juanignacio-martin/TRABAJO-FIN-DE-GRADO-Mediciones-Asfalto/README.md

# TRABAJO-FIN-DE-GRADO-Mediciones-Asfalto
Diseño e implementación del software de control y monitorización de un sistema de instrumentación avanzado para medidas de resistencia en asfalto.

Repositorio útil para investigadores de caminos para entendimiento del código usado en la versión final de la segunda PCB.

Abierto Público durante semana 28 Sept - 4 Oct, para presentación de TFG. 

Last update SEPT 26.
