juanignacio-martin/TRABAJO-FIN-DE-GRADO-Mediciones-Asfalto/DISEÑO/PCB-cara_inferior.pdf

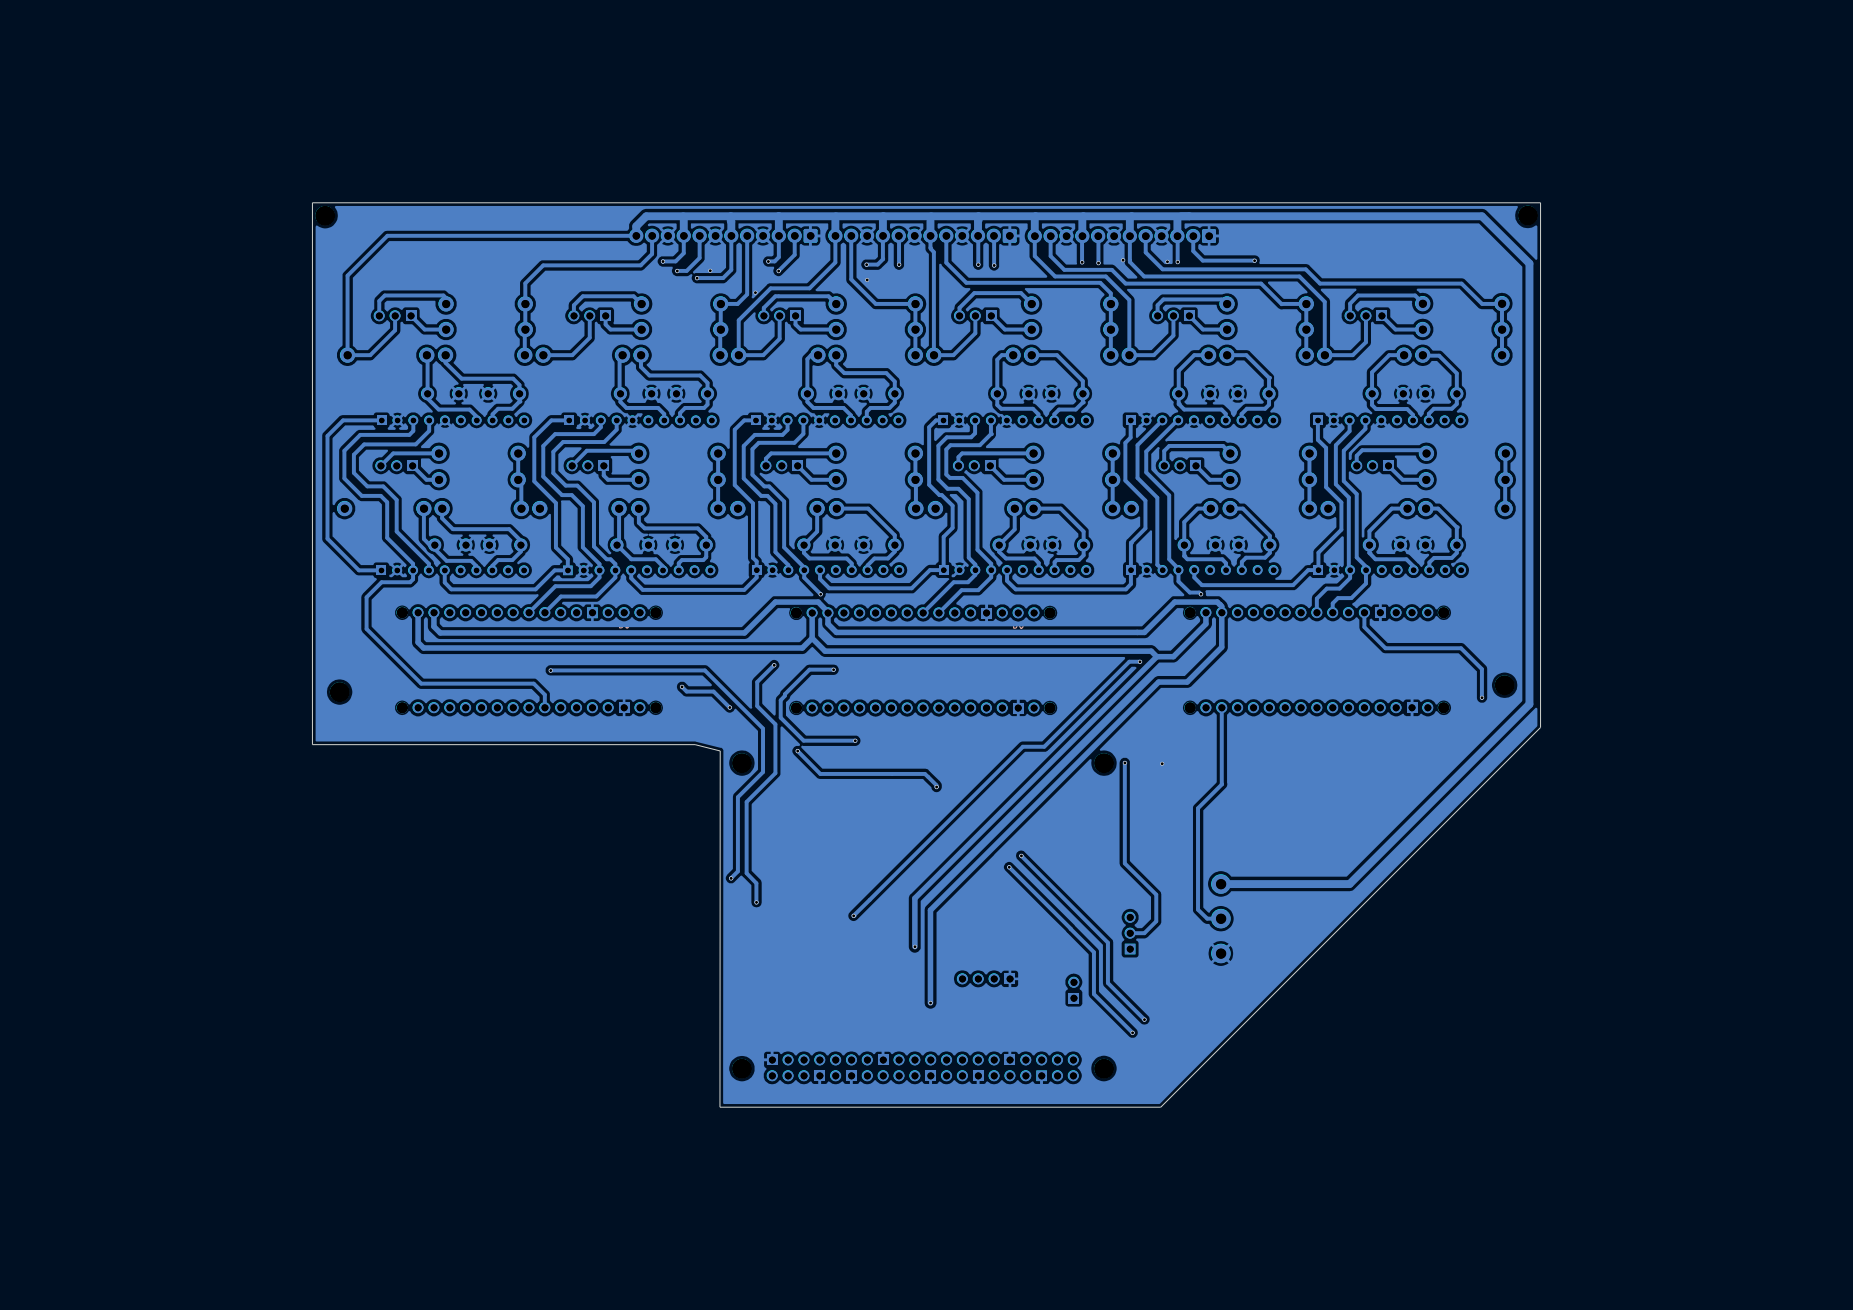
[picture p2: page 1]
