juanignacio-martin/TRABAJO-FIN-DE-GRADO-Mediciones-Asfalto/DISEÑO/PCB-cara_superior.pdf

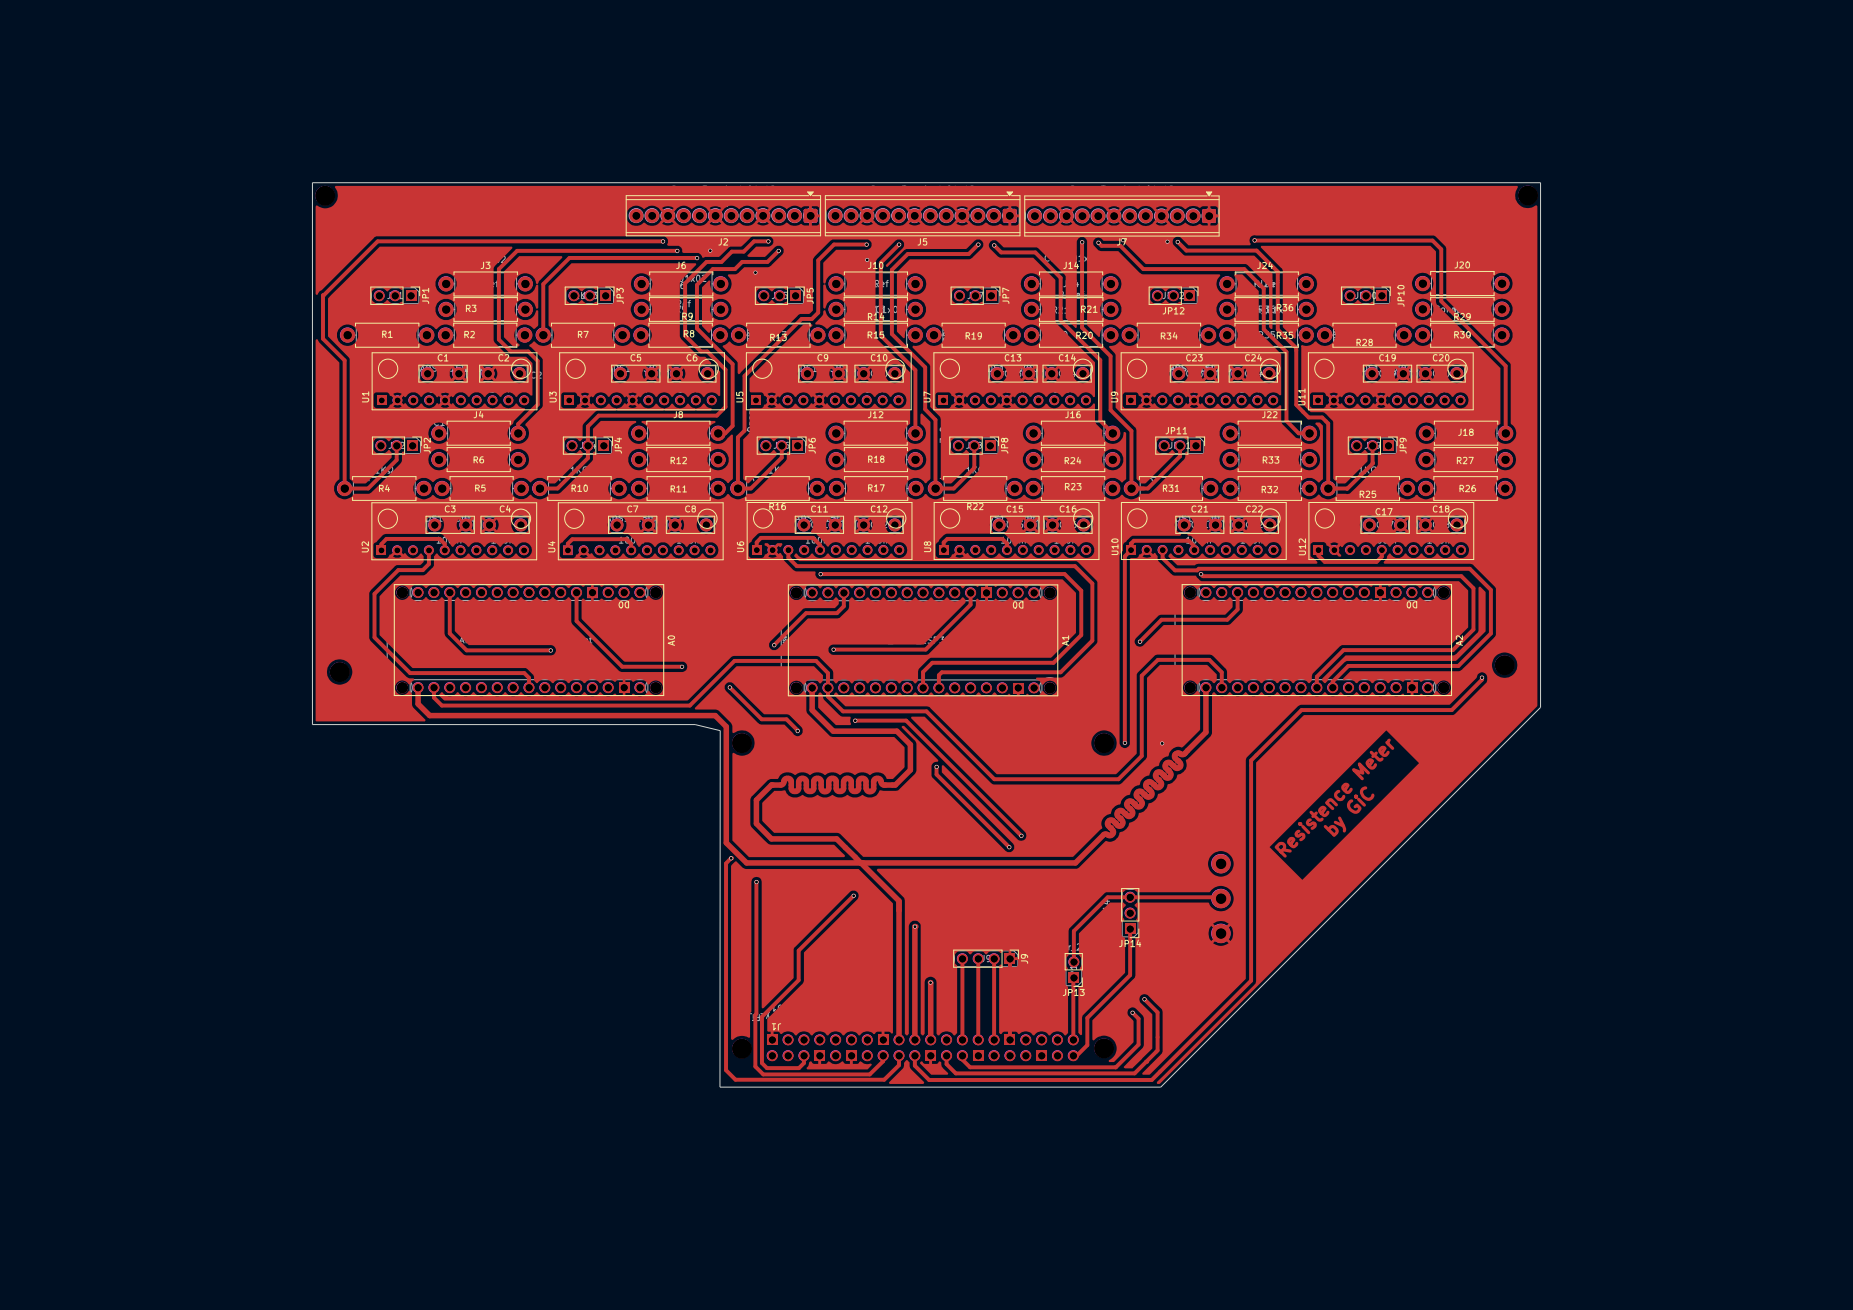
[picture p3: page 1]
