juanignacio-martin/TRABAJO-FIN-DE-GRADO-Mediciones-Asfalto/DISEÑO/SCHEMATIC-PCB2.pdf

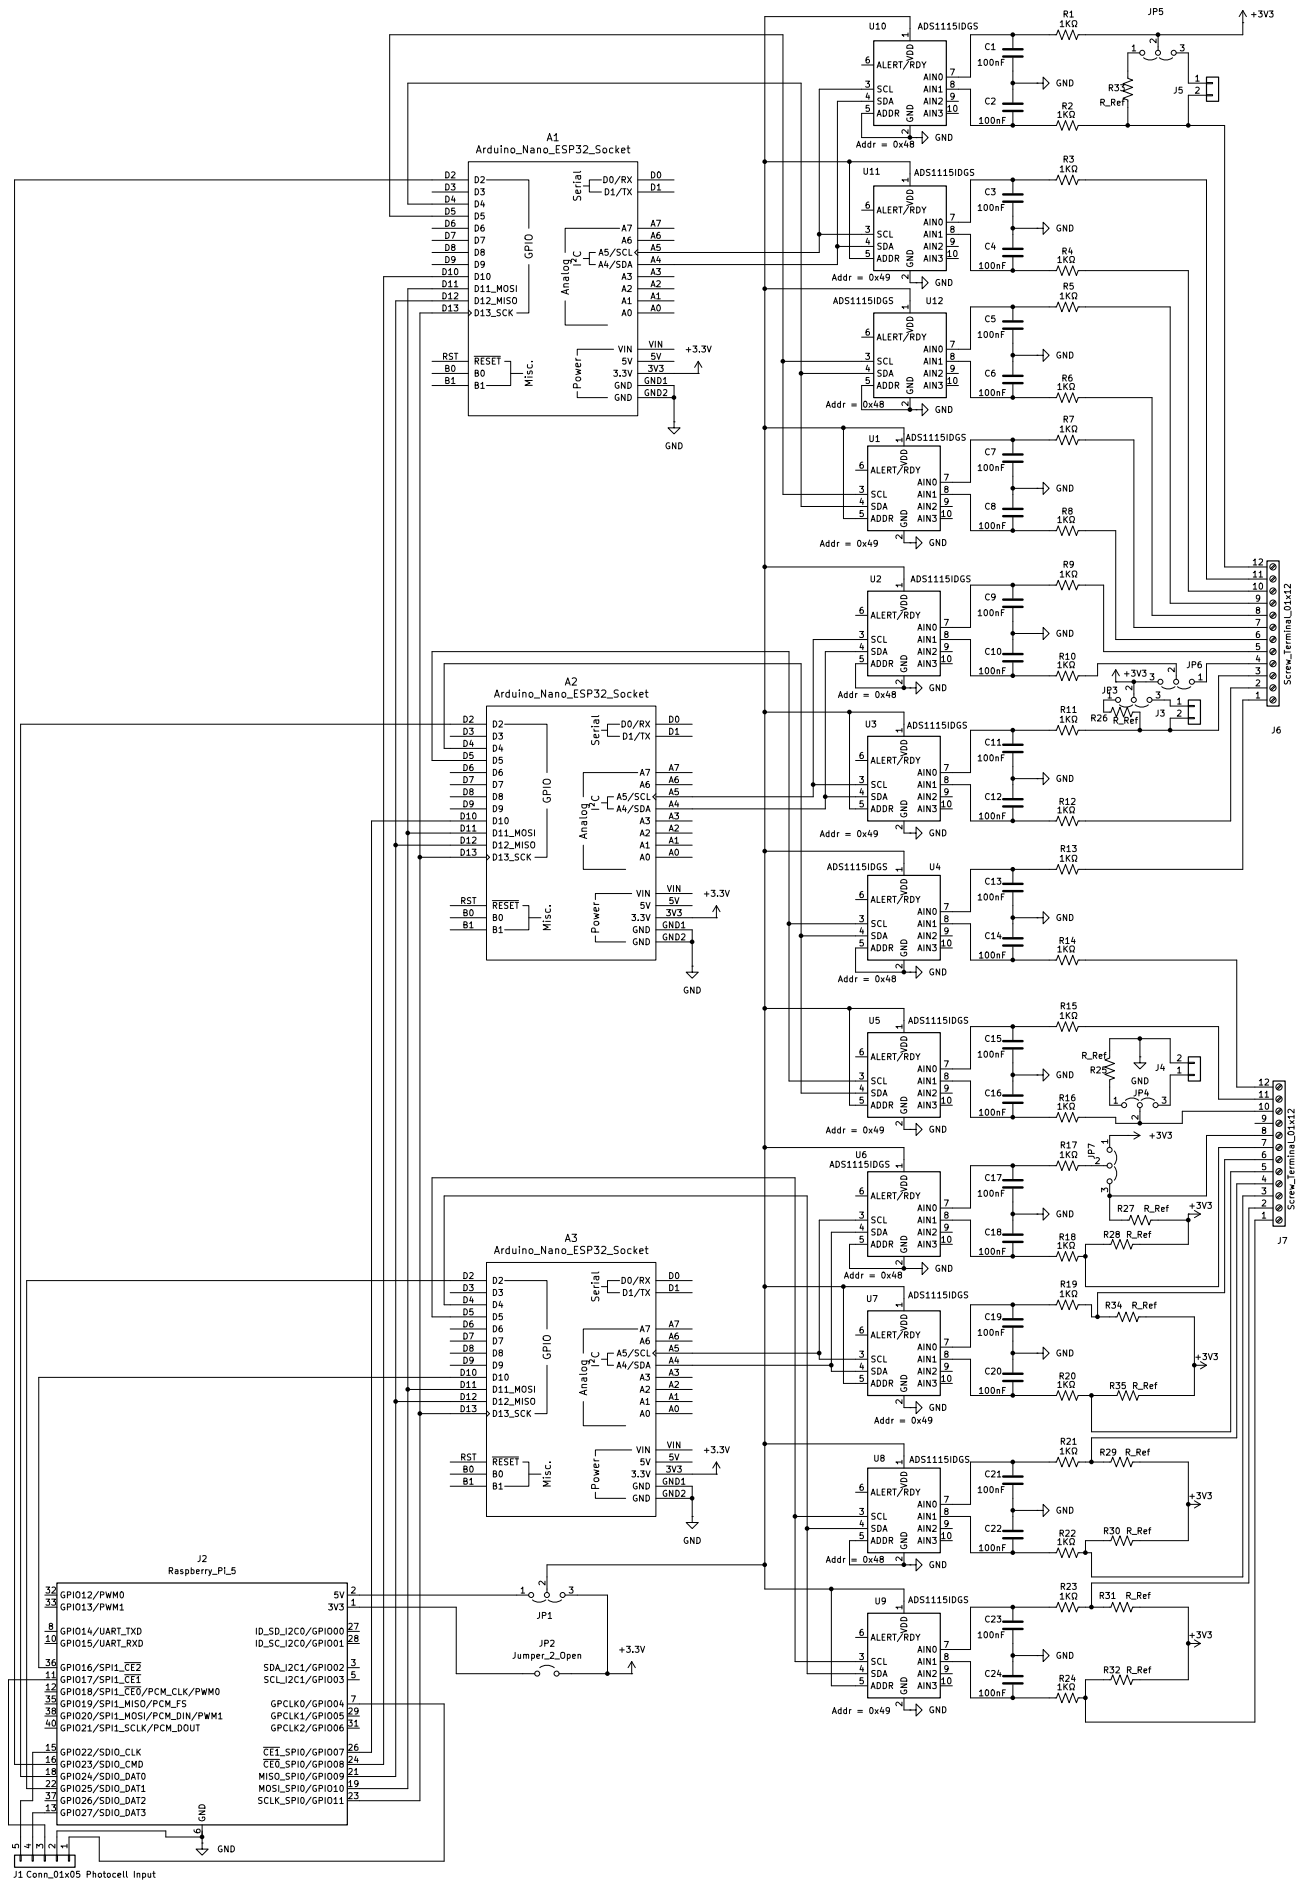
[picture p4: page 1]
